CalvinBrice/UW-Platteville-CookieLab-Spring-2019/README.md

# UWP-CookieLab
Repository to centralize and collaborate code for UW-Platteville Cookie Lab Project
