CalvinBrice/UW-Platteville-CookieLab-Spring-2019/Cookie Lab/Documentation/Control Diagram.pptx

Processing
- GUI (sliders/buttons)
- Communicates with Arduino

Computer

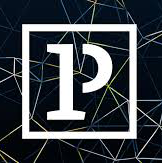
[picture p3: figure]
Image result for processing

Slave 1 (0x08)
Train
- Controls the location of the train
- Interfaces with the ultrasonic sensor

Slave 2 (0x09)
Dispenser
- Controls the stepper motors of the dispenser

USB

Slave 3 (0x10)
Gripper
- Stepper motors
- Servos
- Limit switches

Slave 4 (0x11)
Mixer/Former
- Controls the motors of the mixer and former

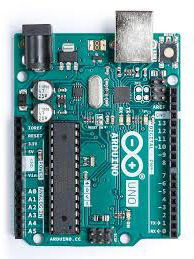
[picture p4: figure]
Image result for arduino

Master (0x00)
- Running main code

I2C Communication

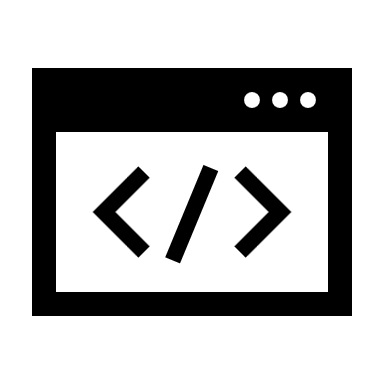
[picture p5: figure]
Web design
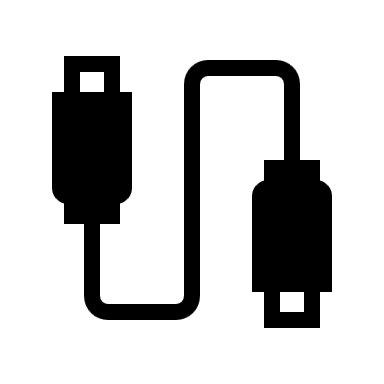
[picture p6: figure]
USB
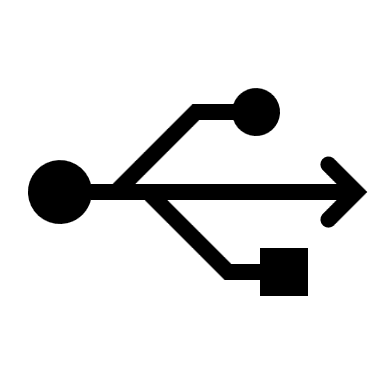
[picture p7: figure]
Plug
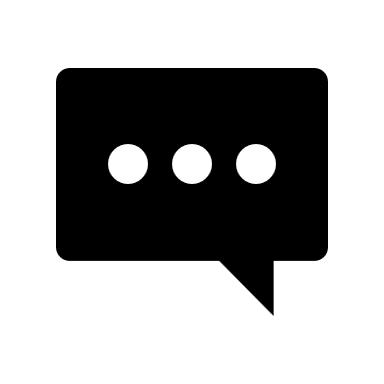
[picture p8: figure]
Chat bubble
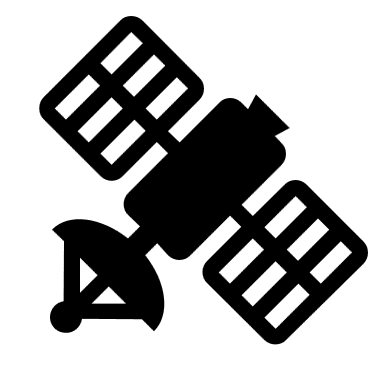
[picture p9: figure]
Satellite
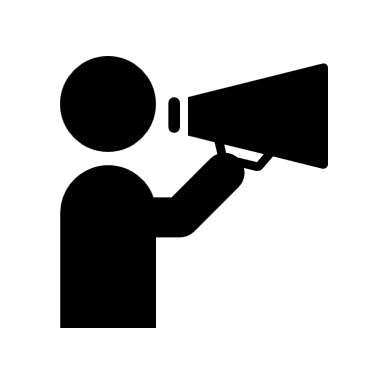
[picture p10: figure]
Marketing
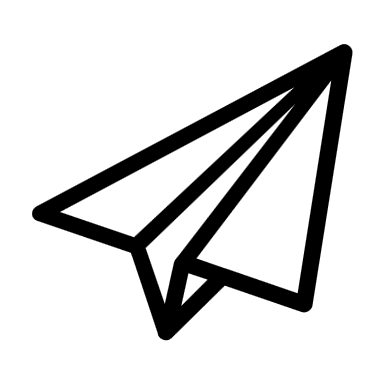
[picture p11: figure]
Send
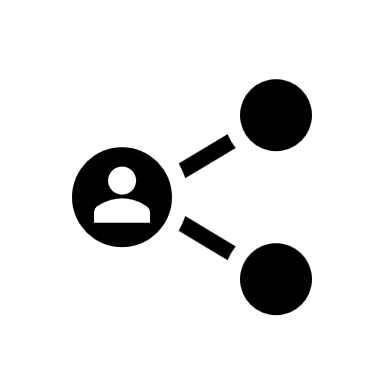
[picture p12: figure]
Share
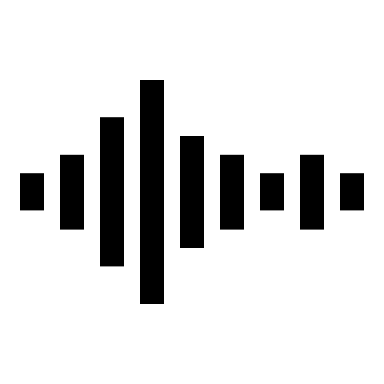
[picture p13: figure]
Voice
