CalvinBrice/UW-Platteville-CookieLab-Spring-2019/Cookie Lab/Documentation/Safety Labels.pptx

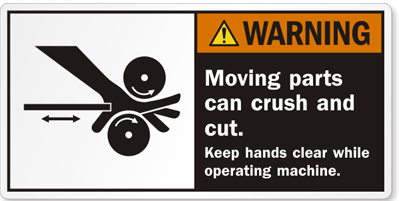
[picture p48: figure]
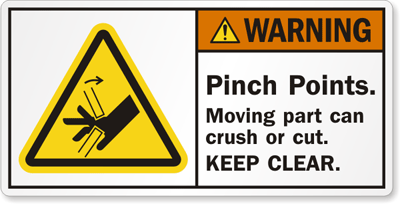
[picture p49: figure]
Image result for safety warning labels
