CalvinBrice/UW-Platteville-CookieLab-Spring-2019/Cookie Lab/Pictures/Dispenser/Dispenser.jpg

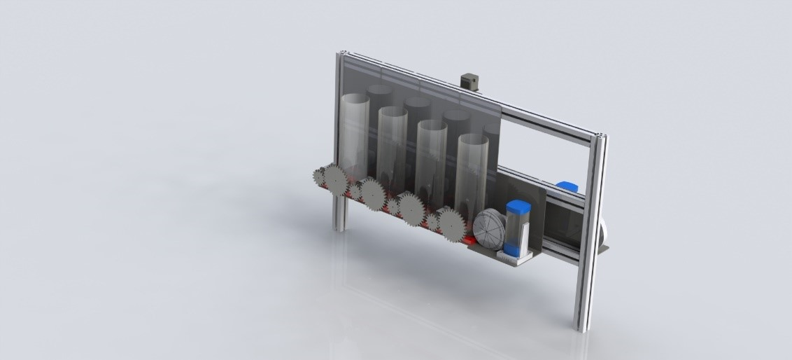
Cookie Lab/Pictures/Dispenser/Dispenser.jpg
