CalvinBrice/UW-Platteville-CookieLab-Spring-2019/Cookie Lab/Pictures/Robotic Arm/3-26-2019 Render.JPG

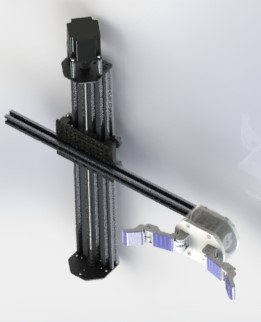
Cookie Lab/Pictures/Robotic Arm/3-26-2019 Render.JPG
