CalvinBrice/UW-Platteville-CookieLab-Spring-2019/Cookie Lab/Pictures/Robotic Arm/Mantis Gripper.png

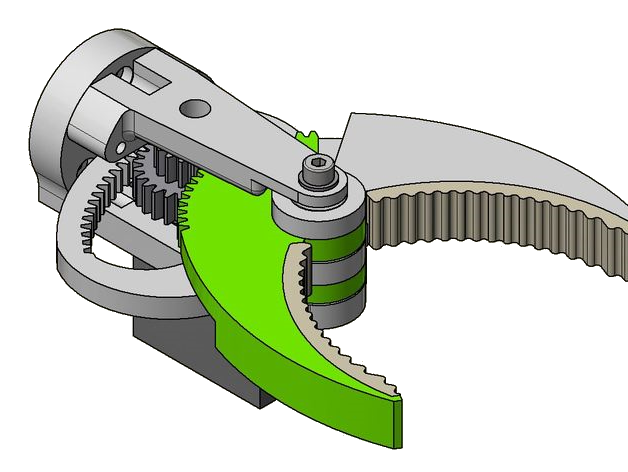
Cookie Lab/Pictures/Robotic Arm/Mantis Gripper.png
