CalvinBrice/UW-Platteville-CookieLab-Spring-2019/Cookie Lab/Pictures/Robotic Arm/OpenHand Gripper.png

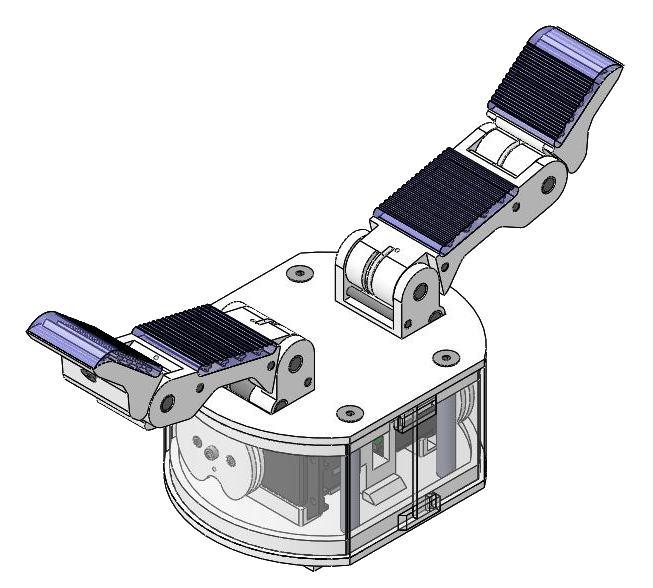
Cookie Lab/Pictures/Robotic Arm/OpenHand Gripper.png
