CalvinBrice/UW-Platteville-CookieLab-Spring-2019/Cookie Lab/Pictures/Shaper/Forming Device.png

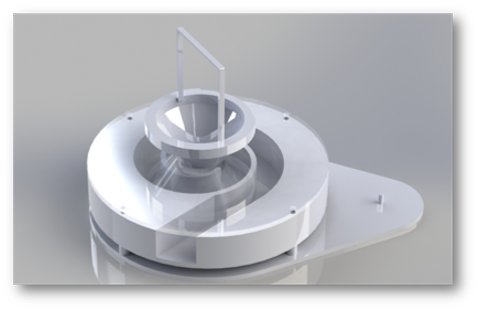
Cookie Lab/Pictures/Shaper/Forming Device.png
