CalvinBrice/UW-Platteville-CookieLab-Spring-2019/Cookie Lab/Pictures/Stock images/Arduino Uno.jpg

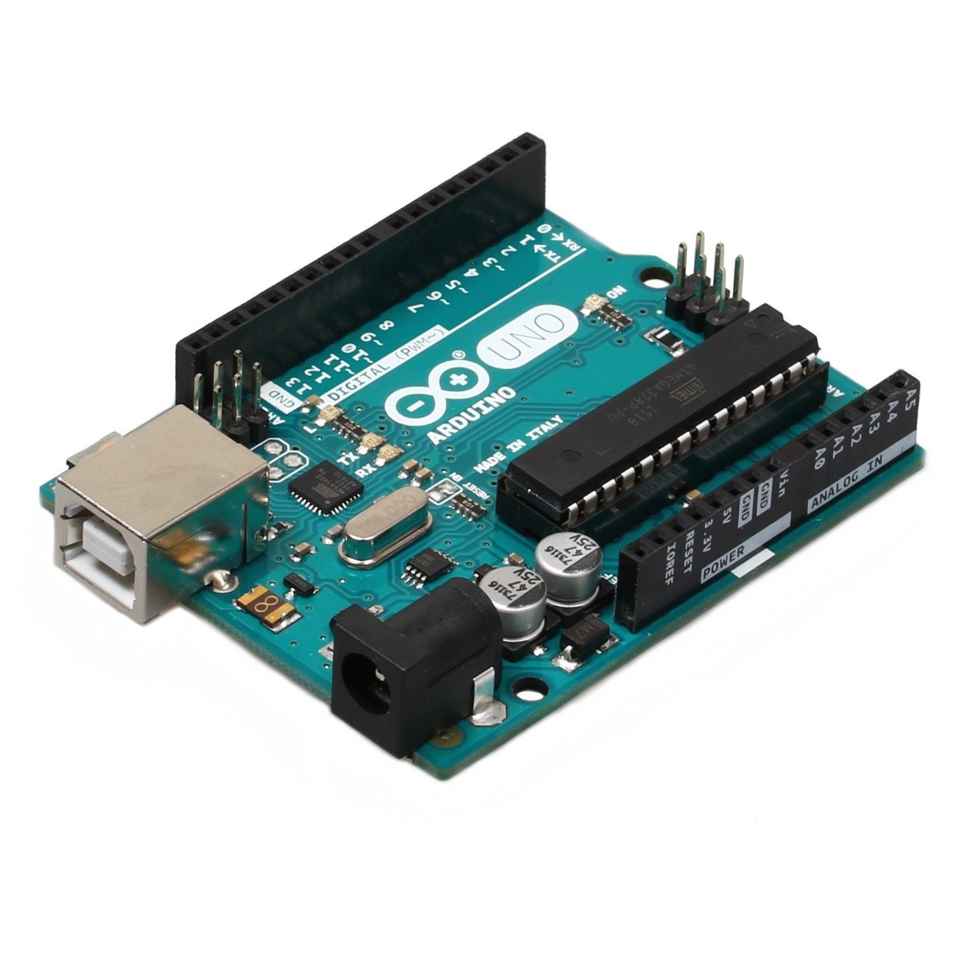
Cookie Lab/Pictures/Stock images/Arduino Uno.jpg
