CalvinBrice/UW-Platteville-CookieLab-Spring-2019/Cookie Lab/Documentation/F01 - ME Funding Spreadsheet.xlsx

Sheet: Funding Source 1
Funding Source: |  |  | SREF
Budget: |  |  | $1000
https://www.amazon.com/hz/wishlist/ls/ZD8Y8OT1KW0D?ref_=wl_share
Date | Vendor | Category | Item | quantity | Cost per item | shipping cost | Total Cost | Notes (web address, reference document, etc)
2019-02-18 | Amazon | Shared | Digital scale | 1 | $12.59 | $5.99 | $18.58
2019-02-20 | Amazon | Shared | Plastic Beaker Set | 1 | $5.48 | $5.99 | $11.47
2019-03-15 | Amazon | Shared | Power HD HD-1501MG High Torque MG Servo | 2 | $18.99 | $0.00 | $37.98
2019-03-15 | Amazon | Gripper | Fishing Line 150Yd 100lb | 1 | $14.95 | $0.00 | $14.95
2019-03-15 | Amazon | Mixer | Hamilton Beach 62682RZ Hand Mixer | 1 | $14.99 | $0.00 | $14.99
2019-03-15 | Amazon | Shared | Stepper Motor Nema 17 (3X) | 1 | $34.99 | $0.00 | $34.99
2019-03-15 | Amazon | Mixer | T8 Lead Screw Kit | 1 | $16.69 | $0.00 | $16.69
2019-03-15 | Amazon | Shared | Arduino Uno R3 | 1 | $16.99 | $0.00 | $16.99
2019-03-15 | Amazon | Shared | Motor Driver Shield | 1 | $5.39 | $0.00 | $5.39
2019-03-15 | Amazon | Shared | 80/20 Bolt Assembly | 1 | $8.99 | $0.00 | $8.99
2019-03-22 | Amazon | Shared | Mechanical Endstop Limit Switch | 1 | $10.99 | $0.00 | $10.99
2019-03-22 | Amazon | Former | Motor High Torque | 2 | $19.79 | $0.00 | $39.58
2019-03-26 | Amazon | Gripper | Servo extenders | 1 | $6.99 | $0.00 | $6.99
2019-03-26 | Amazon | Gripper | Servo Y-splitters | 1 | $6.99 | $0.00 | $6.99
2019-03-26 | Amazon | Gripper | Vytaflex 30 Urethane | 1 | $36.35 | $0.00 | $36.35
2019-03-26 | Amazon | Mixer | DC 24V 300RPM Gear Motor | 1 | $15.49 | $0.00 | $15.49
2019-03-26 | Amazon | Mixer | DC 12V 50RPM Gear Motor | 1 | $15.49 | $0.00 | $15.49
2019-03-29 | Amazon | Gripper | NEMA 23 Stepper Motor Driver | 1 | $39.95 | $0.00 | $39.95 | https://www.amazon.com/dp/B074TBMC7N/?coliid=I2FQGICWXM43I1&colid=ZD8Y8OT1KW0D
2019-03-29 | Amazon | Shared | 12V Power supply | 1 | $20.99 | $0.00 | $20.99 | https://www.amazon.com/dp/B01LATMSGS/?coliid=I1KZMHNUVBX12J&colid=ZD8Y8OT1KW0D
2019-03-29 | Amazon | Gripper | Arduino Uno Motor Shield | 1 | $11.99 | $0.00 | $11.99 | https://www.amazon.com/dp/B07L6JJNRJ/?coliid=I3FCRISX2Q4HA7&colid=ZD8Y8OT1KW0D
2019-03-29 | Amazon | Shared | Fused power switch | 1 | $6.99 | $0.00 | $6.99 | https://www.amazon.com/dp/B00ME5YAPK/?coliid=I2032GHGAXU2L&colid=ZD8Y8OT1KW0D
2019-03-29 | Amazon | Shared | Timing belt and pulleys | 1 | $13.99 | $0.00 | $13.99 | https://www.amazon.com/Wangdd22-Pulley-Timing-Locking-printer/dp/B06XNPHDS5?s=gateway
2019-03-29 | Amazon | Shared | Cable wrap | 1 | $8.99 | $0.00 | $8.99 | https://www.amazon.com/Copapa-Polyethylene-Spiral-Computer-6MM-Length21M/dp/B01LYF1GDV?s=gateway
2019-04-12 | Amazon | Shared | Buck converter (voltage step down, 8 pack) | 1 | $10.99 | $0.00 | $10.99 | https://www.amazon.com/dp/B07C2QF1T1/?coliid=I1MOLOP6YUDYVN&colid=ZD8Y8OT1KW0D
2019-04-12 | Amazon | Gripper | 20kg Servo | 1 | $13.29 | $0.00 | $13.29
2019-04-12 | Amazon | Shared | 24V Power supply | 1 | $20.61 | $0.00 | $20.61
2019-04-17 | Amazon | Shared | Adjust-A-Cup | 1 | $12.71 | $5.99 | $18.70
2019-04-19 | Amazon | Gripper | FS-20W 20KG Servos | 2 | $13.29 | $0.00 | $26.58
2019-04-24 | Amazon | Shared | Arduino Uno Motor Shield | 1 | $11.99 | $5.99 | $17.98
2019-04-30 | Amazon | Shared | Push measuring cups | 2 | $12.71 | $0.00 | $25.42
2019-05-02 | Amazon | Gripper | 12V Nema 17 Stepper Motor | 1 | $17.59 | $5.99 | $23.58
2019-05-06 | Amazon | Shared | Antrader 6pcs Inlet Module |  | $10.99 | $5.99 | $16.98
2019-04-15 | Heiser | Shared | Extension Cord | 1 | $9.99 | $0.00 | $9.99
2019-04-15 | Heiser | Shared | Plug Strip | 1 | $14.99 | $0.00 | $14.99
2019-04-15 | Heiser | Former | Fasteners | 4 | $0.28 | $0.00 | $1.12
2019-04-15 | Heiser | Former | Fasteners | 4 | $0.33 | $0.00 | $1.32
2019-04-15 | Heiser | Former | Fasteners | 4 | $0.10 | $0.00 | $0.40
2019-04-15 | Heiser | Shared | Clear tote w/lid | 1 | $3.59 | $0.00 | $3.59
2019-03-15 | McMaster-Carr | Shared | T-Slotted Framing | 1 | $23.57 | $0.00 | $23.57
2019-03-15 | McMaster-Carr | Gripper | Tapered Heat-Set Inserts for Plastic | 1 | $10.82 | $0.00 | $10.82
2019-03-15 | McMaster-Carr | Gripper | Black-Oxide Alloy Steel Hex Drive Flat Head Screw | 1 | $8.26 | $12.05 | $20.31
2019-03-29 | McMaster-Carr | Gripper | Ø1/4”, L1-1/2”, 8-32 zinc-plated female standoff | 5 | $1.31 | $0.00 | $6.55 | https://www.mcmaster.com/#93330A482
2019-03-29 | McMaster-Carr | Gripper | Torsion spring, 0.340” OD, 0.028” wire diameter | 1 | $4.63 | $0.00 | $4.63 | https://www.mcmaster.com/9271k605
2019-03-29 | McMaster-Carr | Gripper | 8-32, L3/4” countersunk bolt | 1 | $6.62 | $0.00 | $6.62 | https://www.mcmaster.com/#92210a197
2019-03-29 | McMaster-Carr | Shared | 3" Turntable | 2 | $2.29 | $0.00 | $4.58 | https://www.mcmaster.com/6031k16
2019-03-29 | McMaster-Carr | Mixer | 4" Turntable | 2 | $3.11 | $5.60 | $11.82
2019-04-05 | McMaster-Carr | Mixer | Sleeve Bearing Carriage for T-Slotted Framing | 2 | $43.51 | $5.14 | $92.16 | https://www.mcmaster.com/catalog/125/1994
2019-04-30 | McMaster-Carr | Shared | Spring Tab Drop-in Fastener | 20 | $1.46 | $5.15 | $34.35
2019-03-26 | Openbuildspartstore | Gripper | V-Slot® NEMA 23 Linear Actuator Bundle (Lead Screw) | 1 | $129.99 | $0.00 | $129.99 | V-Slot® NEMA 23 Linear Actuator Bundle (Lead Screw) (https://openbuildspartstore.com/v-slot-nema-23-linear-actuator-bundle-lead-screw/)
2019-03-26 | Openbuildspartstore | Gripper | NEMA 23 Stepper Motor | 1 | $27.99 | $14.20 | $42.19 | NEMA 23 Stepper Motor (https://openbuildspartstore.com/nema-23-stepper-motor/)
2019-03-21 | SteelMart | Former | Stainless Steel/Aluminum Stock | 1 | $113.00 | $0.00 | $113.00
Total |  |  |  |  |  |  | $1121.93

Sheet: Budget Pivot
Category | Cost
Former | 155.42
Gripper | 401.78
Mixer | 166.64
Shared | 398.09
Grand Total | 1121.93
