CalvinBrice/UW-Platteville-CookieLab-Spring-2019/Cookie Lab/Processing Download/processing-3.5.3/modes/java/examples/Basics/Shape/LoadDisplayOBJ/data/rocket.obj

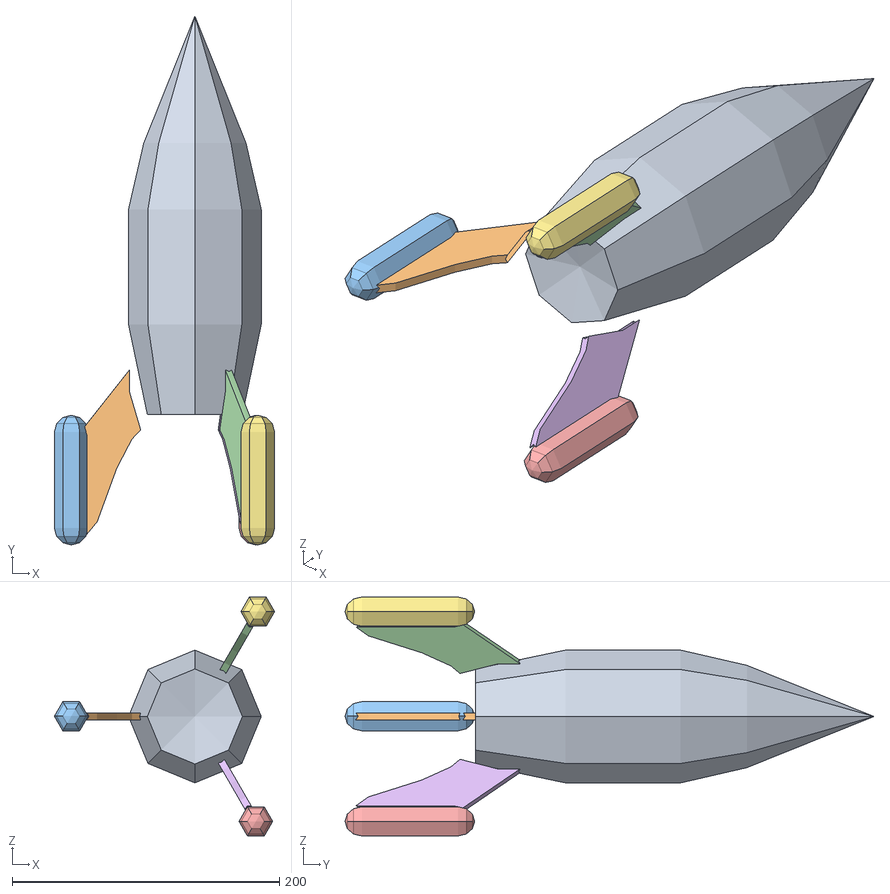
[picture p93: CAD file, 2019-05-06]
Cookie Lab/Processing Download/processing-3.5.3/modes/java/examples/Basics/Shape/LoadDisplayOBJ/data/rocket.obj
164.8 x 395.7 x 178.8
Rocket
wing01
reactor01
wing02
reactor03
wing03
reactor02
