CalvinBrice/UW-Platteville-CookieLab-Spring-2019/(threads)

Thread 1 (2019-04-27):

Tasks

CalvinBrice, 2019-04-27:
- [x] Finish my changes
- [ ] Push my commits to GitHub
- [ ] Open a pull request

CalvinBrice, 2019-04-28:
- [ ] Update dispenser code to move motors via i2c (@FilipinoGambino)

Thread 2 (2019-05-11):

No need to wait after Wire.requestFrom().

Koepel, 2019-05-11:
The `while (!Wire.available());` after a `Wire.requestFrom()` may be removed.
Explanation: [Common-mistakes#1](https://github.com/Koepel/How-to-use-the-Arduino-Wire-library/wiki/Common-mistakes#1)

I noticed it in the file:
 - UW-Platteville-CookieLab-Spring-2019/Cookie Lab/Code/2 - Arduino_Master/I2C_Master/requestInfoFromSlave.ino

And it is also in these files which contain only one function:
 - requestCapacitanceFromSlave.ino
 - readUSensor.ino
 - readCapSensor.ino
 - askCartAtDestination.ino
 - requestCapacitanceFromSlave.ino
 - dispenseIngredients.ino

Koepel, 2019-05-14:
And also in "requestInductanceFromSlave.ino".

CalvinBrice, 2019-05-16:
Thank you Koepel! Our senior design team is just about wrapping up this project for the semester, but I will make sure that Nick (the author of those files) is aware of your comments. We have had such a huge learning experience over the last couple of months and appreciate all of the help we have received.
