CalvinBrice/UW-Platteville-CookieLab-Spring-2019/Cookie Lab/Code/2 - Arduino_Master/Master_And_Dispenser_Controller/Master_And_Dispenser_Controller.ino

#include <Wire.h>
#include <Adafruit_MotorShield.h>

#define STEPS_PER_REV 200

int Steps;
int Jog = 20; //defines the step "length" of the jog button
int ButterJog = 5000;
int BakingSodaJog = 5;

// Create the motor shield object with the default I2C address
Adafruit_MotorShield AFMS_0 = Adafruit_MotorShield(0x60); // default board ID
Adafruit_MotorShield AFMS_1 = Adafruit_MotorShield(0x61); // board ID + 1
Adafruit_MotorShield AFMS_2 = Adafruit_MotorShield(0x62); // board ID + 2
Adafruit_MotorShield AFMS_3 = Adafruit_MotorShield(0x63); // board ID + 3
Adafruit_MotorShield AFMS_4 = Adafruit_MotorShield(0x64); // board ID + 4
Adafruit_MotorShield AFMS_5 = Adafruit_MotorShield(0x65); // board ID + 5

// Connect a stepper motors with 200 steps per revolution (1.8 degree)
Adafruit_StepperMotor *myMotor1 = AFMS_0.getStepper(STEPS_PER_REV, 1); //   Butter
Adafruit_StepperMotor *myMotor2 = AFMS_0.getStepper(STEPS_PER_REV, 2); //   Vanilla
Adafruit_StepperMotor *myMotor3 = AFMS_1.getStepper(STEPS_PER_REV, 1); //   Molasses
Adafruit_StepperMotor *myMotor4 = AFMS_1.getStepper(STEPS_PER_REV, 2); //   Egg
Adafruit_StepperMotor *myMotor5 = AFMS_2.getStepper(STEPS_PER_REV, 1); //   Sugar
Adafruit_StepperMotor *myMotor6 = AFMS_2.getStepper(STEPS_PER_REV, 2); //   Baking soda
Adafruit_StepperMotor *myMotor7 = AFMS_3.getStepper(STEPS_PER_REV, 1); //   Chocolate chips
Adafruit_StepperMotor *myMotor8 = AFMS_3.getStepper(STEPS_PER_REV, 2); //   Oats
Adafruit_StepperMotor *myMotor9 = AFMS_4.getStepper(STEPS_PER_REV, 1); //   Flour
Adafruit_StepperMotor *myMotor10 = AFMS_4.getStepper(STEPS_PER_REV, 2); //  Salt
Adafruit_StepperMotor *myMotor11 = AFMS_5.getStepper(STEPS_PER_REV, 1); //  M&M's
Adafruit_DCMotor *myMotor12 = AFMS_5.getMotor(3); //  dc motor relay for flour agitator using port 3 (M3)

enum Slaves {MASTER = 0x08, CART = 0x09, ARM = 0X10};
enum Commands {NONE, CART_CONTROL, ULTRASONIC_CONTROL, INDUCTOR_CONTROL, DISPENSER_CONTROL};
enum CartControl {CART_NONE, CART_GO_TO_INDUCTOR, CART_GO_TO_ULTRASONIC, TRACK_SWITCH_STRAIGHT, TRACK_SWITCH_CURVED};
enum Sensors {NO_SENSOR, U1, U2, INDUCTOR};
enum DispenserControl {STOP, DISPENSE, MOVE_UP, MOVE_DOWN};
enum TrackDirection {CURVED, STRAIGHT}; // Basically boolean with straight as false (0) and curved as true (1)
DispenserControl mode = STOP;

Slaves slave = CART;
Commands command = NONE;

struct Ingredients {
  String label;
  int location;
  int trackDirection;
  int quantity;
};

Ingredients ingredient[] = { // Sets default parameters for each ingredient
  // label, location, trackDirection, quantity
  {"Butter",          126, STRAIGHT, 2}, // 'location' is relative to the ultrasonic sensors where 1024 is nearest it and 1 is furthest away (0 means it doesn't see anything
  {"Sugar",           379, STRAIGHT, 2}, // or that something is in the blind zone which is 0 - 4ish inches from the ultrasonic sensor).
  {"Molasses",        532, STRAIGHT, 2},
  {"Vanilla",         721, STRAIGHT, 2},
  {"Egg",             903, STRAIGHT, 2},
  {"Add in 2",        90,  CURVED,   2},
  {"Chocolate Chips", 207, CURVED,   2},
  {"Salt",            360, CURVED,   2},
  {"Baking Soda",     661, CURVED,   2},
  {"Flour",           785, CURVED,   2},
  {"Oatmeal",         940, CURVED,   2}
};

int destination = 1100;
byte destArray[] = {(destination >> 8) & 0xFF, destination & 0xFF};
int numberOfBays = 11;

bool mainInControl = true;

void setup() {
  Wire.begin(MASTER);
  Wire.onReceive(receiveEvent);
  Serial.begin(9600);
  //  setupMotors();
}

void receiveEvent() {
  while (!Wire.available());
  mainInControl = Wire.read();
}

void serialEvent() {
  while (!Serial.available());
  int num = Serial.read();
  while (Serial.available() < num);
  for (int i = 0; i < num; i++) ingredient[i].quantity = Serial.read();
}

void loop() {
//doneDispensing(4,1);
//while(!Serial.available());
//while(Serial.available()) Serial.read();
  int sum = 0;
  for (int i = 0; i < numberOfBays; i++) sum += ingredient[i].quantity; // Resets to wait for next recipe
  while (!mainInControl); // only goes through loop if the master is in control of the clock line
  if (sum == 0) return;
  for (int i = 0; i < numberOfBays; i++) {
    if (i != 0 && ingredient[i].trackDirection != ingredient[i - 1].trackDirection) { // Checks to see if the cart needs to switch branches
      sendCommand(CART, CART_GO_TO_INDUCTOR); // Start of the "switching branches" sequence
      while (!requestInductanceFromSlave()); // Wait for the cart to get to the inductive sensor
      if (ingredient[i].trackDirection) sendCommand(CART, TRACK_SWITCH_STRAIGHT);
      if (!ingredient[i].trackDirection) sendCommand(CART, TRACK_SWITCH_CURVED);
    } // End of the "switching branches" sequence
    if (ingredient[i].quantity == 0) continue; // Ignore null ingredient quantities
    if (!ingredient[i].trackDirection) sendCommand(CART, TRACK_SWITCH_STRAIGHT);
    if (ingredient[i].trackDirection) sendCommand(CART, TRACK_SWITCH_CURVED);
    sendCommand(CART, CART_GO_TO_ULTRASONIC);
    while (!readUSensor(CART, ULTRASONIC_CONTROL, ingredient[i].location, ingredient[i].trackDirection));
    while (!doneDispensing(i, ingredient[i].quantity));
  }
  sendCommand(CART, CART_GO_TO_INDUCTOR);
  while (!requestInductanceFromSlave());
//  while (!serialWait()); // Used for testing arm and master arduinos
  giveArmControl(); // Makes the arm the master
  mainInControl = false; // Returns master-ness back to this board
  for (int i = 0; i < numberOfBays; i++) ingredient[i].quantity = 0; // Resets to wait for next recipe
}
