CalvinBrice/UW-Platteville-CookieLab-Spring-2019/Cookie Lab/Code/5 - Arduino_Gripper/GripperControlV5_serialControl/GripperControlV5_serialControl.ino

// zoomkat 10-22-11 serial servo test
// type servo position 0 to 180 in serial monitor
// or for writeMicroseconds, use a value like 1500
// for IDE 0022 and later
// Powering a servo from the arduino usually *DOES NOT WORK*.

String readString;
#include <Servo.h>
Servo servo1;  // create servo object to control a servo
Servo servo2;  // create servo object to control a servo

const byte numChars = 32;
char receivedChars[numChars]; // an array to store the received data

boolean newData = false;
int n = 0;    // variable to store the servo position

String inString = "";    // string to hold input

void setup() {
  // Open serial communications and wait for port to open:
  Serial.begin(9600);
  while (!Serial) {
    ; // wait for serial port to connect. Needed for native USB port only
  }

  // send an intro:
  Serial.println("\n\nString toInt():");
  Serial.println();
  servo1.attach(9);  //the pin for the servo control
  servo2.attach(10);  //the pin for the servo control
}

void loop() {
  // Read serial input:
  while (Serial.available() > 0) {
    int inChar = Serial.read();
    if (isDigit(inChar)) {
      // convert the incoming byte to a char and add it to the string:
      inString += (char)inChar;
    }
    // if you get a newline, print the string, then the string's value:
    if (inChar == '\n') {
      Serial.print("Value:");
      Serial.println(inString.toInt());
      Serial.print("String: ");
      Serial.println(inString);
      servo1.write(inString.toInt());              // tell servo to go to position in variable 'pos'
      servo2.write(inString.toInt());              // tell servo to go to position in variable 'pos'
      delay(15);                       // waits 15ms for the servo to reach the position
      // clear the string for new input:
      inString = "";
    }
  }
}
