CalvinBrice/UW-Platteville-CookieLab-Spring-2019/Cookie Lab/Code/5 - Arduino_Gripper/Processing_xBox360_v1/Processing_xBox360_v1.pde

import processing.serial.*;
import net.java.games.input.*;
import org.gamecontrolplus.*;
import org.gamecontrolplus.gui.*;
import cc.arduino.*;
import org.firmata.*;

ControlDevice cont;
ControlIO control;
Arduino arduino;
float thumb;

void setup() {
  size(360, 200);
  control = ControlIO.getInstance(this);
  cont = control.getMatchedDevice("xbs");

  if (cont == null) {
    println("no controller detected"); // write better exit statements than me
    System.exit(-1);
  }
  println(Arduino.list());
  arduino = new Arduino(this, Arduino.list()[2], 57600);
  arduino.pinMode(10, Arduino.SERVO);
}

public void getUserInput() {
  thumb = map(cont.getSlider("servoPos").getValue(), -1, 1, 0, 180);
}

void draw() {
  getUserInput();
  background(thumb,100,255);
  arduino.servoWrite(10, (int)thumb);
}
