CalvinBrice/UW-Platteville-CookieLab-Spring-2019/Cookie Lab/Code/2 - Arduino_Master/Master_And_Dispenser_Controller/askCartAtDestination.ino

 bool askCartAtDestination(byte slave, int sentVariable, int destination, int sensor)  {
  Wire.beginTransmission(slave);
  Wire.write(sentVariable);
  Wire.write(sensor);
  Wire.write(destArray, 2);
  Wire.endTransmission(slave);
  
  Wire.requestFrom(slave,1);
  return Wire.read();
}
