CalvinBrice/UW-Platteville-CookieLab-Spring-2019/Cookie Lab/Code/2 - Arduino_Master/Master_And_Dispenser_Controller/flour.ino

void flour(int quantity, int mode) {
  switch (mode) {
    case DISPENSE:
      // step one revolution  in one direction:
      Steps = quantity * 100;
//      Serial.println("Number of steps = "+String(Steps));
//      Serial.println("Running flour dispenser and agitator");
//      Serial.println("-----------------------------------------------");
      myMotor12->run(FORWARD); //Starting the agitator and delaying for one second
      delay(1000);
      myMotor9->step(Steps, FORWARD, INTERLEAVE); //Starting the flour dispenser
      myMotor9->release(); //end function be removing power from the motor
      delay(2000); //Delaying 5 seconds before shutting off the agitator
      myMotor12->run(RELEASE); //end function be removing power from the motor
      break;
    case MOVE_UP:
      myMotor9->step(Jog, FORWARD, DOUBLE);
      myMotor9->release(); //remove all power from the motor
      break;
    case MOVE_DOWN:
      myMotor9->step(Jog, BACKWARD, DOUBLE);
      myMotor9->release(); //remove all power from the motor
      break;
    default:
      break;
  }
  reset();
}
