CalvinBrice/UW-Platteville-CookieLab-Spring-2019/Cookie Lab/Code/2 - Arduino_Master/Master_And_Dispenser_Controller/types.ino

void types(char num) {
  Serial.println("It's a char");
}

void types(float num) {
  Serial.println("It's a float");
}

void types(String num) {
  Serial.println("It's a String");
}

void types(byte num) {
  Serial.println("It's a byte");
}

void types(int num) {
  Serial.println("It's an int");
}
