CalvinBrice/UW-Platteville-CookieLab-Spring-2019/Cookie Lab/Code/2 - Arduino_Master/Serial_Input_At_Dispensers/requestCapacitanceFromSlave.ino

bool requestCapacitanceFromSlave() {
  Wire.beginTransmission(CART);
  Wire.write(CAP_CONTROL);
  Wire.endTransmission(CART);
  
  Wire.requestFrom(CART, 1);
  while (!Wire.available()); // Should be stuck here until the capacitance sensor is triggered
  return Wire.read();
}
