CalvinBrice/UW-Platteville-CookieLab-Spring-2019/Cookie Lab/Code/I2C_Scanner/I2C_Scanner/I2C_Scanner.ino

// I2C Scanner
// Written by Nick Gammon
// Date: 20th April 2011

#include <Wire.h>

void setup() {
  Serial.begin (9600);
  Wire.begin();

  Serial.println ();
  Serial.println ("I2C scanner. Scanning ...");
  byte count = 0;

  for (byte i = 8; i < 120; i++){
    Wire.beginTransmission (i);
    if (Wire.endTransmission () == 0){
      Serial.print ("Found address: ");
      Serial.print (i, DEC);
      Serial.print (" (0x");
      Serial.print (i, HEX);
      Serial.println (")");
      count++;
      delay (1);  // maybe unneeded?
      } // end of good response
  } // end of for loop
  Serial.println ("Done.");
  Serial.print ("Found ");
  Serial.print (count, DEC);
  Serial.println (" device(s).");
}  // end of setup

void loop() {}
