CalvinBrice/UW-Platteville-CookieLab-Spring-2019/Cookie Lab/Code/1 - Processing_GUI/Cookie_Machine_Processing/Cookie_Machine_Processing.pde

/*------------------------------------------------------------------------------------
 Program:     Cookie Lab GUI
 Description:       
 Purpose:                   
 Hardware:       
 
 Date:        27 April 2019   
 Author(s):   Calvin Brice, Nicholas Gorichs
 ------------------------------------------------------------------------------------*/

import controlP5.*;
import processing.serial.*;
import java.util.*;

ControlP5 cp5; //<>//

PFont font;
int myColorBackground = color(20, 20, 20);
String val;     // Data received from the serial port

// explore controlp5 tab feature for menus?

int xBorder = 50;   //Space for the first slider
int xSpace = 120;   //Spacing between sliders
int tempDist = 130; //Moving the sliders and button down a little for the dropdown lists until we figure out how to make a new, password accessible window

/* Naming structure
    Sliders - Ingredient Name (e.g. 'Sugar')
    DropdownMenues - Bay # (e.g. 'bay1')
    Tabs - "default", "Settings"
    Ingredient Name Labels - Ingredient Name and Number (e.g. 'Sugar1')
    Ingredient Value Labels - 'Amount' and Number (e.g. 'Amount1)
*/

void setup() {
  font = createFont("Verdana", 14);
  size(1400, 600); // use fullscreen() eventually
  background(myColorBackground);
  cp5 = new ControlP5(this);
  cp5.setFont(font);

  setIngredients();

  // Setup elements
  setupTabs();
  setupSerialSelection();
  setupSliders();
  setupButtons();
  setupDropdownMenus();
  setupTextLabels();
}

void draw() {
  background(myColorBackground);
  updateComPorts();
  updateIngredients();
}
