CalvinBrice/UW-Platteville-CookieLab-Spring-2019/Cookie Lab/Code/1 - Processing_GUI/Cookie_Machine_Processing/setupButtons.pde

// Create buttons
void setupButtons() {
  cp5.addButton("Dispense")
    .setPosition((width/2)-75, 500) //xBorder + 0*xSpace
    .setSize(150, 50);
}

//cp5.getController("sliderValue").moveTo("Settings");
