CalvinBrice/UW-Platteville-CookieLab-Spring-2019/(commit log)

2019-04-20 Added support for an xbox one wireless controller
2019-04-20 Updated xbox wireless v2
2019-04-25 i2c communication working
2019-04-27 Updated serial selection
    Serial selection now uses controlP5 buttons for a more uniform interface and simplified code
2019-04-27 Linear actuator update
2019-04-28 Full rewrite of automated gripper
2019-04-28 marker to upload final CAD files
2019-04-28 Added previous teams CAD
    [1539727345821.sldasm, 2.11.015015.43LPx12.00(1).sldprt, 2.11.015015.43LPx21.00(2).sldprt, 2.21.15E0.sldprt, Baking Soda Assembly.SLDASM, Baking Soda Assembly_Mounting Plate with holes and bend.SLDASM, Baking Soda Housing.SLDDRW, Baking Soda Mounting Plate Bend.SLDDRW]
2019-04-28 Added "struct"
    There doesn't appear to be a struct type in Processing, but I found that it's basically the same thing as a public class. Everything for setting up the ingredients is in IngredientBayConfig.
    [IngredientBayConfig.pde, controlEvent.pde, setupDropdownMenus.pde, setupSliders.pde]
2019-04-28 Proper Dispense Value
    Added 'Update' function in the ingredient class to correctly adjust the slider value for each ingredient
    [IngredientBayConfig.pde, controlEvent.pde, setupDropdownMenus.pde, setupSliders.pde]
2019-04-29 GUI Settings Password Protection
    Added a text field and some buttons that enable password protection of certain settings.
    The password is "password"
2019-04-29 Sliders Updated
    text() doesn't recognize the different tabs so it was on every tab. Switched to using cp5's TextLabel.
    [IngredientBayConfig.pde, setupDropdownMenus.pde, setupSliders.pde, setupTextLabels.pde]
2019-04-29 Stareted sending to arduino code
    Currently it just puts the ingredient bay numbers into a list. Still no default value.
2019-05-01 Outputting
    Code outputs to wire and to serial just fine, but the sorting isn't working quite yet.
2019-05-02 Switching dispenser code over
    Switching dispenser code over from using Megunolink to using I2C via Wire
2019-05-02 LED profile
2019-05-02 Modifications
    No real progress mode. Simply cleaned the code up by creating a struct for the ingredients. Added dispenser I2C communication inside moveTrain after train has made it to the location (make sure it's stopped?). Train slave needs to communicate its position to master.
2019-05-02 Linear actuator updates
2019-05-02 Base rotation for stepper
2019-05-02 Ready for testing
    Moved wire and serial communication for processing to arduino into permanent files.
2019-05-04 Removed version name
    -Removed version name; no longer necessary with GitHub
    -Tested creating a standalone executable file (successful)
    [Cookie_Machine_Processing.pde, IngredientBayConfig.pde, SerialPortSelection.pde, controlEvent.pde, sendToArduinoMaster.pde, setupButtons.pde, setupDropdownMenus.pde, setupSliders.pde]
2019-05-05 Updated supporting documentation
    -BOM
    -Pictures/video
    [BOM - F01 - ME Funding Spreadsheet.xlsx]
2019-05-06 Started testing
    Of course things are going to need to change with testing. Attempting to implement writing an initial command to a slave before wire.requestfrom happens to wire.onrequest the appropriate data.
    [cars2.tsv, data.csv, java15.g, pde.g, rocket.obj]
2019-05-07 Automated arm update
2019-05-07 Linear actuator manual control
2019-05-09 Automation gripper update
2019-05-09 Gripper update
2019-05-11 Update gripper
2019-05-11 i2c automation
2019-05-13 Starting Integration
    Starting integration between dispenser/cart and arm designs.
2019-05-14 I2C Integration
2019-05-14 I2C Integration (cont)
2019-05-16 Cleaned up code
    1. moved obsolete code
    2. added descriptions for all functions in robotic arm code
    3. commented most lines
    4. added some warnings
2019-05-16 Updated documentation and CAD files
    [1539727345821.sldasm, 2.11.015015.43LPx12.00(1).sldprt, 2.11.015015.43LPx21.00(2).sldprt, 2.21.15E0.sldprt, BOM - F01 - ME Funding Spreadsheet.xlsx, Baking Soda Assembly.SLDASM, Baking Soda Assembly_Mounting Plate with holes and bend.SLDASM, Baking Soda Housing.SLDDRW]
2019-05-16 Minor changes
    Program worked before we moved the apparatus, but was switched afterward. Program appears to be working on final run today.
2019-05-16 I2C Scanner
